antymistor/remote_controler/遥控手柄/遥控手柄PCB(version_2)/遥控手柄PCB_v2/yksb.png

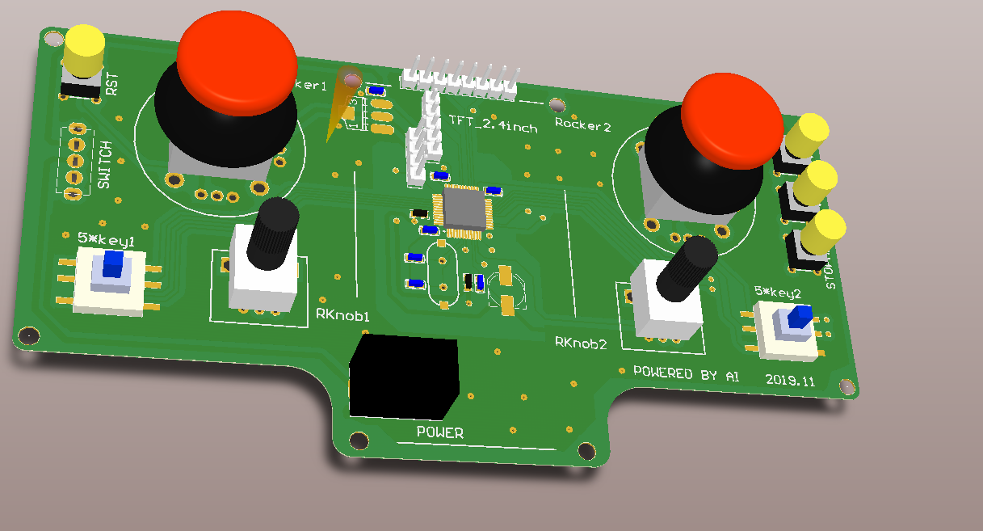
遥控手柄/遥控手柄PCB(version_2)/遥控手柄PCB_v2/yksb.png
