antymistor/remote_controler/遥控手柄/遥控手柄PCB(version_2)/遥控手柄PCB_v2/pin_map.txt

ADC: PA0~5
KEY:PB0~PB12
LCD:PB13~PB15
UART:PA9~10
SWD:PA13~14
