antymistor/remote_controler/遥控手柄/遥控手柄PCB/PCB_Project/yksb.step

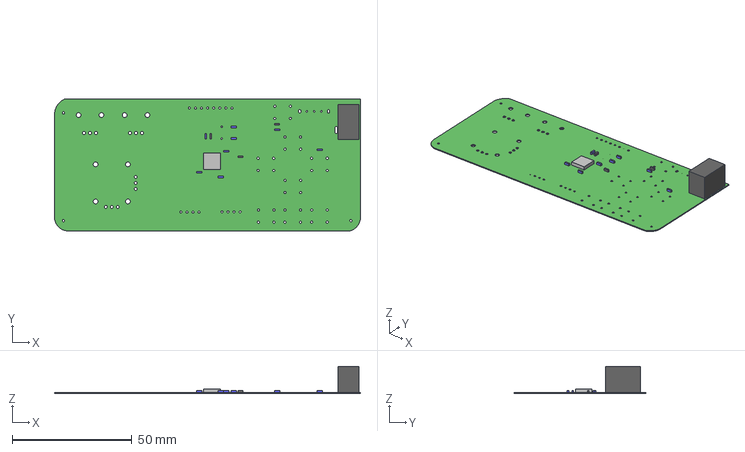
[picture p13: CAD file, 2019-08-25]
遥控手柄/遥控手柄PCB/PCB_Project/yksb.step
127.8 x 55.0 x 11.4 mm
Board
Extruded x 13
