antymistor/remote_controler/(list of files, cad)

Other CAD files:
遥控手柄/遥控手柄strcuture/bottomboard.DWG
遥控手柄/遥控手柄strcuture/topboard.DWG
