antymistor/remote_controler/遥控手柄/遥控手柄PCB/PCB_Project/PCB_Project.pdf

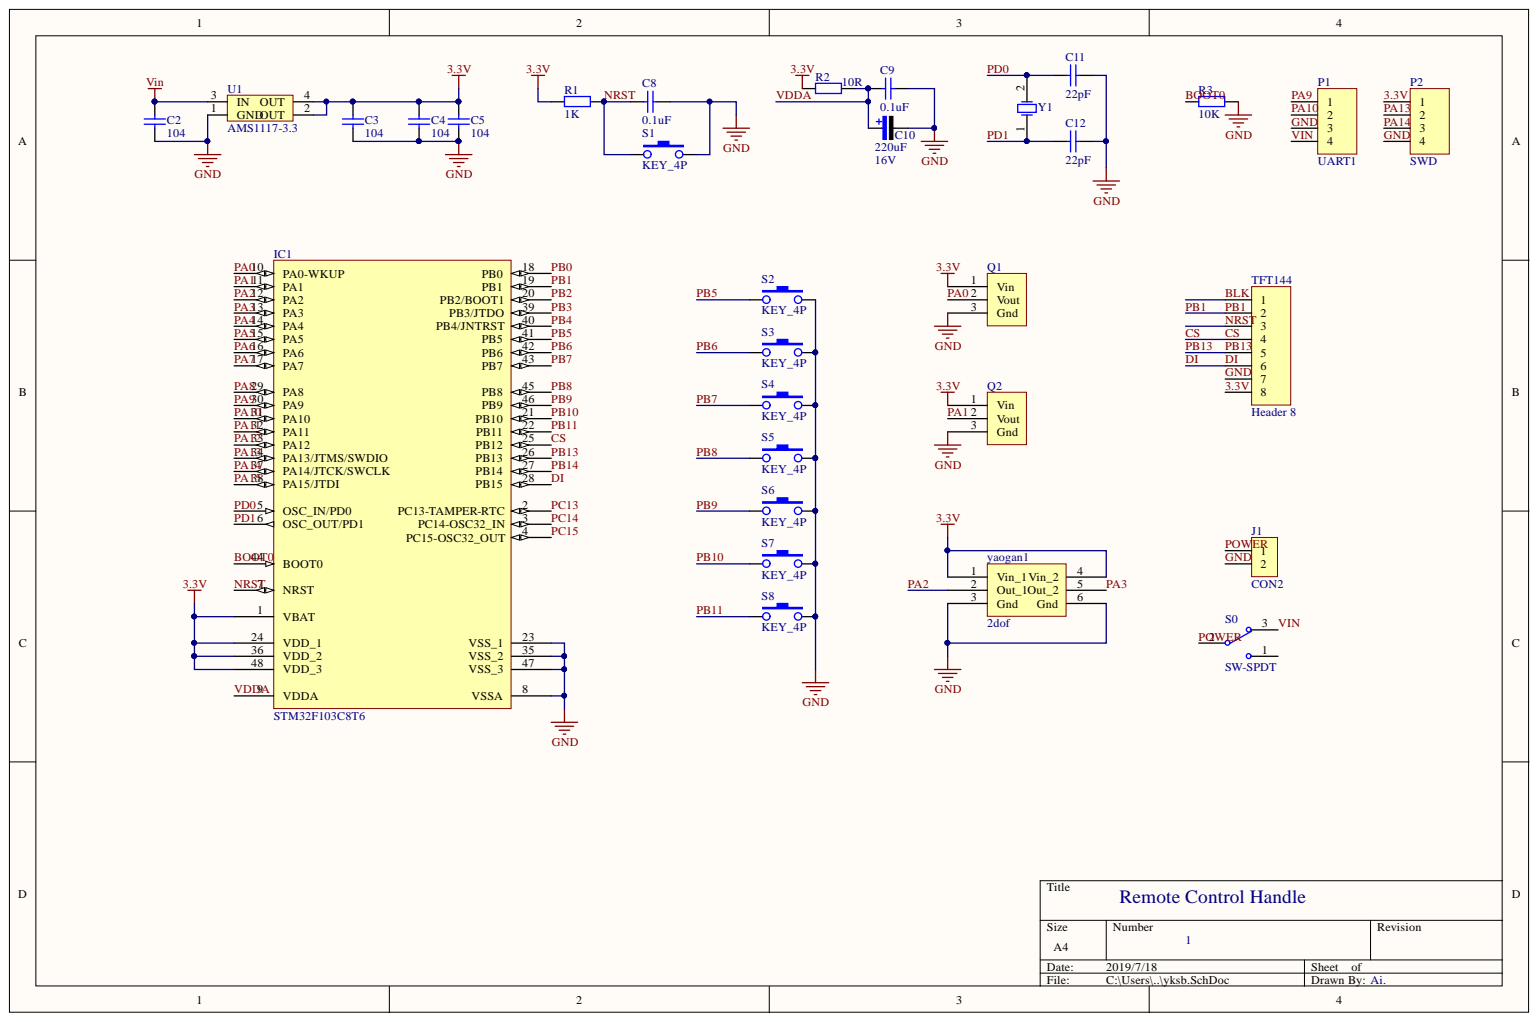
[picture p16: page 1]

3 6 | 3 5
4 8 | 4 7

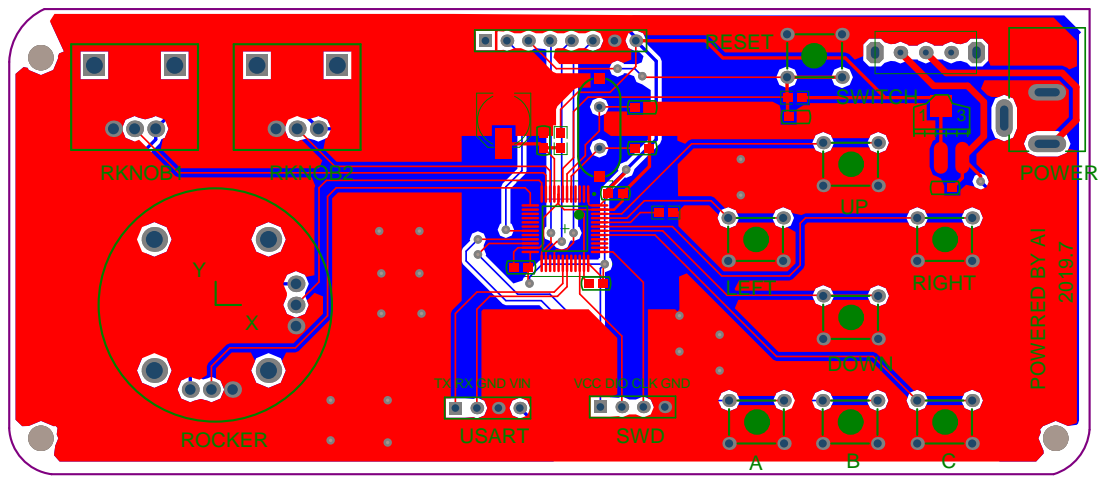
[picture p17: page 2]

Comment | Description | Designator | Footprint | LibRef | Quantity
Cap | 无极性电容 | C2, C3, C4, C5, C8, C9, C11, C12 | C-RAD-0603 | Cap | 8
Cap Pol | 极性电解电容 | C10 | C-RB-S6 | Cap Pol | 1
STM32F103C8T6 | 单片机 | IC1 | LQFP48_M | STM32F103C8T6 | 1
CON2 | 连接器 | J1 | DC-005 | CON2 | 1
UART1 | Header, 4-Pin | P1 | HDR1X4 | Header 4 | 1
SWD | Header, 4-Pin | P2 | HDR1X4 | Header 4 | 1
| | Q1, Q2 | dianweiqi | dianweiqi | 2
Res1 | 贴片电阻 | R1, R2, R3 | 0603-1 | Res1 | 3
SW-SPDT | 开关 | S0 | SWITCH_A2 | SW-SPDT | 1
KEY_4P | 轻触按键4P | S1, S2, S3, S4, S5, S6, S7, S8 | KEY_M | KEY_4P | 8
Header 8 | Header, 8-Pin | TFT144 | HDR1X8 | Header 8 | 1
AMS1117-3.3 | | U1 | AMS1117 | AMS1117 | 1
XTAL | Crystal Oscillator | Y1 | XTAL_US | XTAL | 1
2dof | | yaogan1 | yaogan1 | yaogan1 | 1
