antymistor/remote_controler/(list of files, drawings)

Other design files:
遥控手柄/遥控手柄PCB(version_2)/遥控手柄PCB_v2/yksb.PcbDoc
遥控手柄/遥控手柄PCB(version_2)/遥控手柄PCB_v2/yksb.SchDoc
遥控手柄/遥控手柄PCB(version_2)/遥控手柄PCB_v2/遥控手柄PCB_v2.PrjPcb
遥控手柄/遥控手柄PCB/PCB_Project/PCB_Project.PrjPcb
遥控手柄/遥控手柄PCB/PCB_Project/yksb.PcbDoc
遥控手柄/遥控手柄PCB/PCB_Project/yksb.SchDoc
