antymistor/remote_controler/遥控手柄/遥控手柄code(version_5)/HARDWARE/ADC/adc.h

#ifndef __adc_H
#define __adc_H
#include "stm32f10x.h"


extern u16 AD_Value[6];


void Adc_Init(void);
void Dma_Init(void);
void Analog_Sample_Init(void);
void Analog_Sample_Switch(u8 sw);
void Get_Analog_Value(void);


#endif

//------------------End of File----------------------------
