antymistor/remote_controler/(commit log)

2019-08-25 1st_commit
    1st_commit
    [PCB_Project.PrjPcb, bottomboard.DWG, topboard.DWG, yksb.PcbDoc, yksb.SchDoc, yksb.step]
2019-08-29 3rd commit
    开始加入了遥控器对于丝杆电机以及两个阀这些执行器的控制功能，暂只有显示部分，没有发送单元内容，待补
    [PCB_Project.PrjPcb]
2019-08-31 4th commit
    本次写齐了对其他执行器的控制功能，加入了mode=3（Actuator Ctr)模式,并重写了刷新与采样模式，解决了在mode=2时toggle键不灵敏的问题。
    解决了右键不好用的bug
    [key.c]
2019-09-02 19.9.2 commit
    对控制经行了优化，使在mode3下，不进行操作时遥控器不发出指令，保证了了空中信号的清洁度，使除锈机器人可以正常地在自动模式下工作
2019-11-11 19/11/11 commit
    1. version4 代码全部完成，第一代遥控器控制成熟
    2. 第二代遥控器pcb电路完成
    （见遥控手柄PCB（version_2)文件）
    3.version5 第二代遥控器代码demo
    [yksb.PcbDoc, yksb.SchDoc, 遥控手柄PCB_v2.PrjPcb]
2019-12-16 19/12/16
    版本大更新。
    1.version5 是具有完整控制能力的第二代遥控器代码
